aceglia/scapula_cluster/Geometry_left/scapulaglen_basis_left.stl

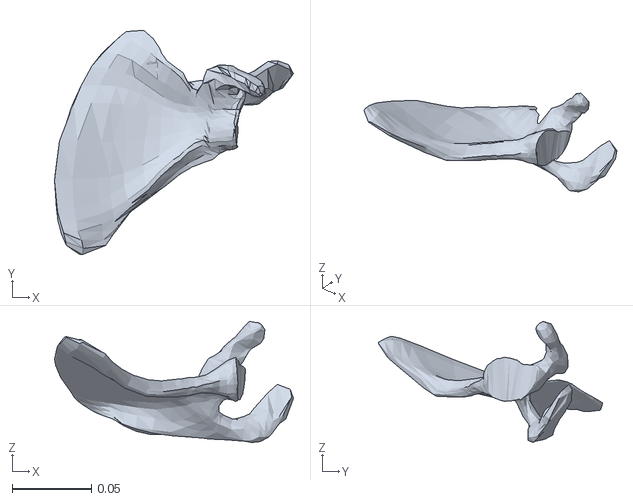
[picture p23: CAD file, 2024-01-19]
Geometry_left/scapulaglen_basis_left.stl
0.151 x 0.142 x 0.0765
