aceglia/scapula_cluster/stl_files/pointing_collar.STL

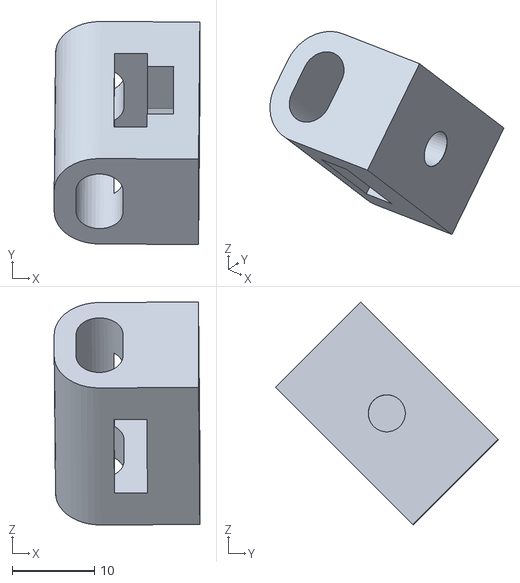
[picture p24: CAD file, 2023-12-07]
stl_files/pointing_collar.STL
17.7 x 27.0 x 27.0
