aceglia/scapula_cluster/stl_files/rgbd_markers.STL

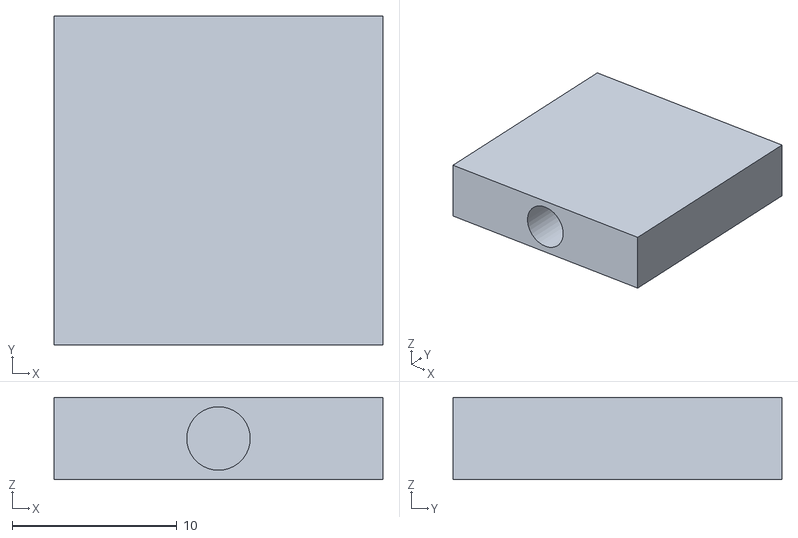
[picture p25: CAD file, 2023-12-07]
stl_files/rgbd_markers.STL
20.0 x 20.0 x 5.00
