aceglia/scapula_cluster/stl_files/cluster.STL

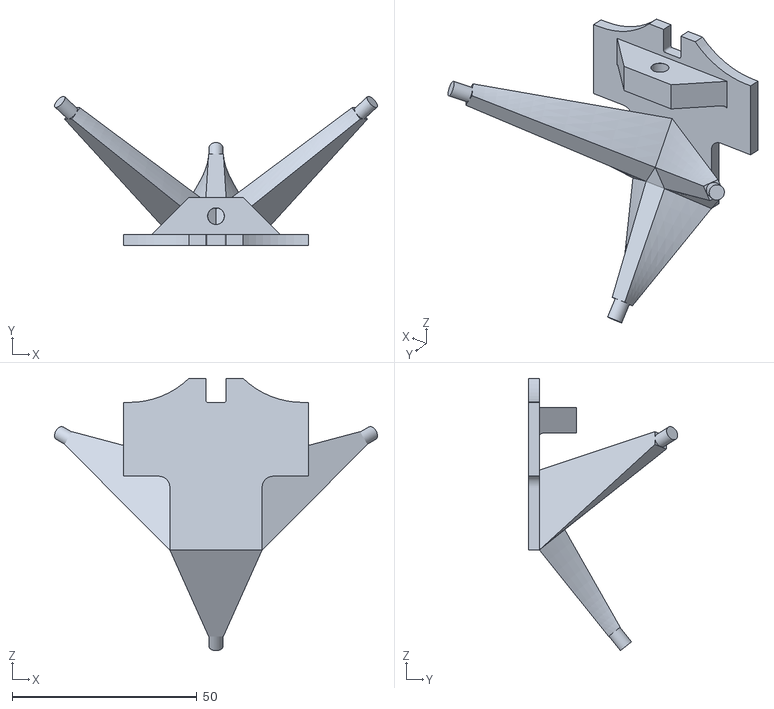
[picture p26: CAD file, 2023-12-07]
stl_files/cluster.STL
87.5 x 40.5 x 73.8
