aceglia/scapula_cluster/stl_files/counter_weight.STL

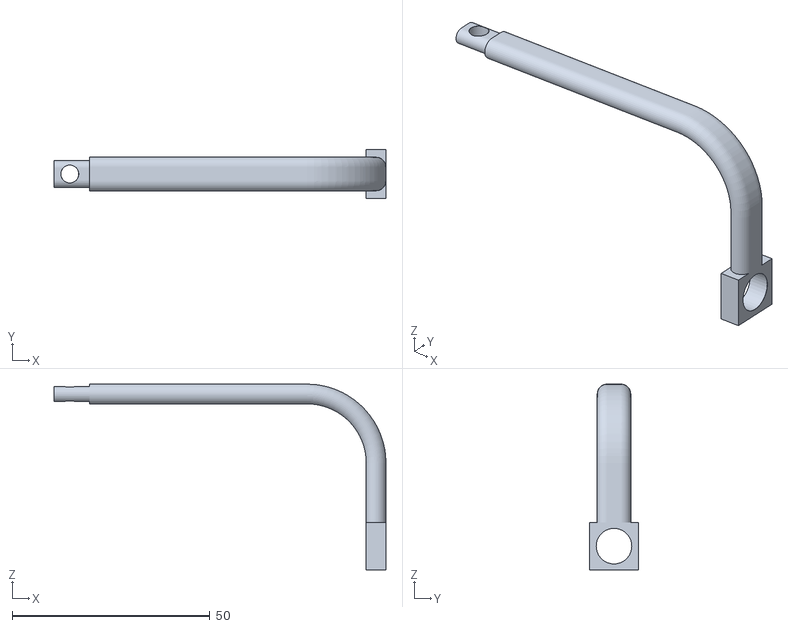
[picture p27: CAD file, 2023-12-07]
stl_files/counter_weight.STL
84.0 x 12.4 x 47.0
