aceglia/scapula_cluster/stl_files/inferior_angle_wand.STL

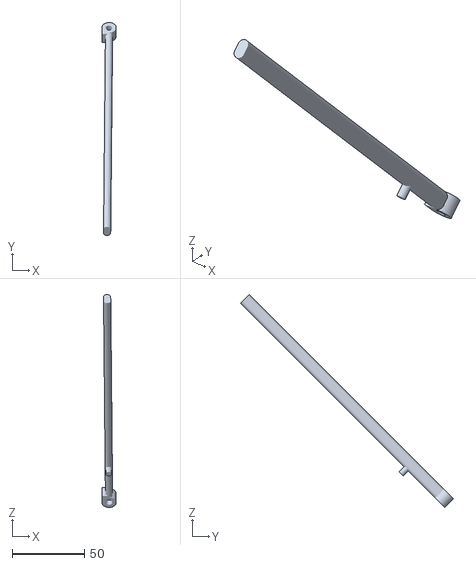
[picture p28: CAD file, 2023-12-07]
stl_files/inferior_angle_wand.STL
10.0 x 147.4 x 147.4
