aceglia/scapula_cluster/stl_files/spine_wand.STL

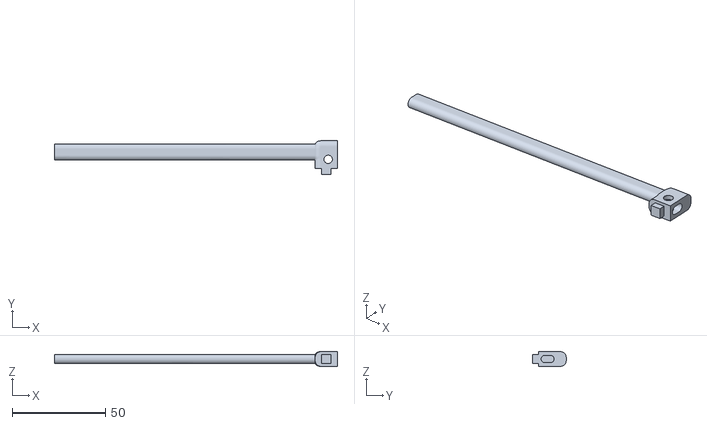
[picture p29: CAD file, 2023-12-07]
stl_files/spine_wand.STL
152.0 x 18.0 x 7.85
