aceglia/scapula_cluster/stl_files/pivot.STL

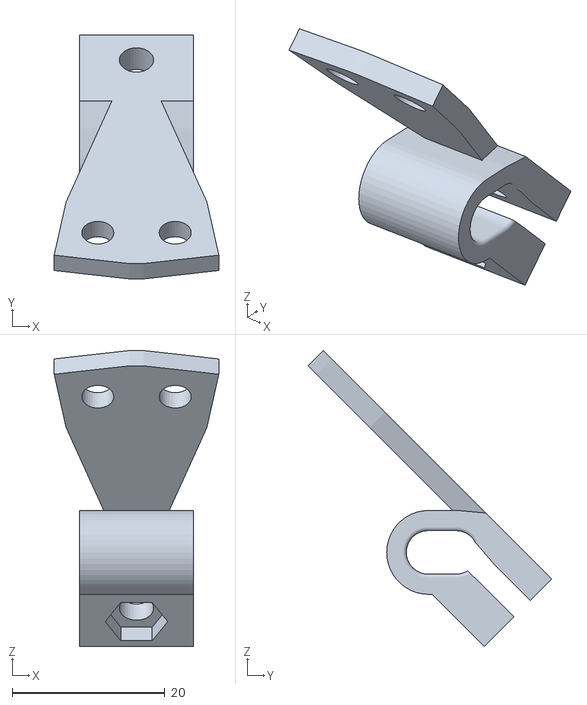
[picture p30: CAD file, 2023-12-07]
stl_files/pivot.STL
21.6 x 32.0 x 38.8
