aceglia/scapula_cluster/stl_files/pointer.STL

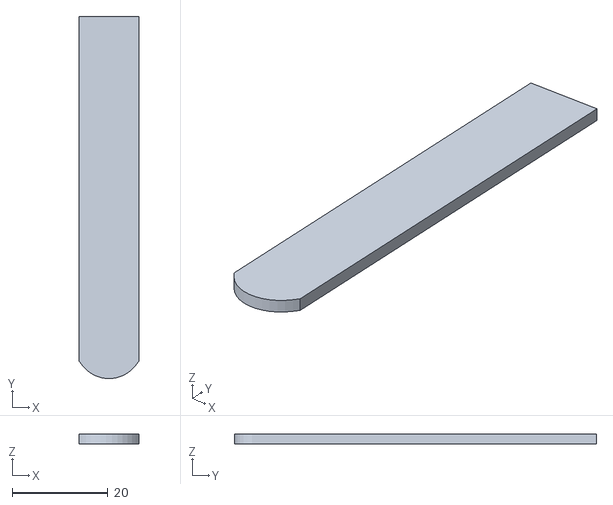
[picture p31: CAD file, 2023-12-07]
stl_files/pointer.STL
12.5 x 75.5 x 2.00
