aceglia/scapula_cluster/(commit log)

2023-12-07 First commit + file in french
    [cluster.STL, counter_weight.STL, inferior_angle_wand.STL, pivot.STL, pointer.STL, pointing_collar.STL, rgbd_markers.STL, spine_wand.STL]
2024-01-19 Auto stash before merge of "main" and "origin/main"
    [scapulaglen_basis_left.stl]
2024-01-30 Fix error while loading markers data instead of files + fix calibration matrix for rgbd screen
2024-09-25 fix: recompute matrix for each frame
2024-11-06 Update gitignore + add data processing files
    [data_df.csv]
